Abdulaziz-nasser/IRD-MAX/hardware/README.md

# Hardware

The Jetson processes camera images and sends driving commands to the Arduino Uno over USB. The Arduino controls the RC380 motor and MG996R steering servo and reads the sensors.

Use the [Uno pin map](PINOUT.md) to check signal connections and the [power notes](power/) for supply information.

| Component | Quantity | Photo or reference |
|---|---|---|
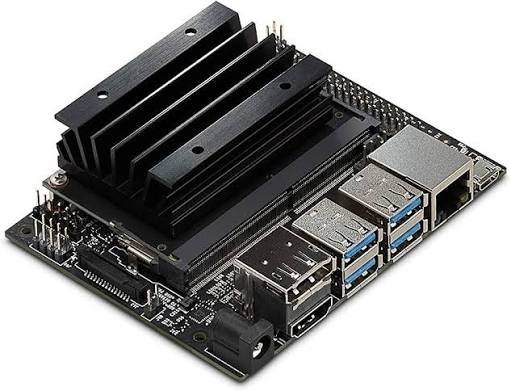
[picture p3: hardware/jetson-nano.png]
NVIDIA Jetson Nano — product reference photo
| NVIDIA Jetson Nano | 1 |  |
| Arduino Uno R3 with shield | 1 | <a href="https://store.arduino.cc/products/arduino-uno-rev3">Arduino Uno with shield — product reference photo</a> <a href="https://thinkrobotics.com/products/io-sensor-shield-online">Arduino Uno with shield — product reference photo</a> |
| HW-039 module | 1 | <a href="https://kitsguru.com/products/double-bts7960b-dc-43a-stepper-motor-driver-h-bridge-pwm-for-arduino-smart-car">HW-039 module — product reference photo</a> |
| IMX477 camera | 1 | <a href="https://thinkrobotics.com/products/waveshare-imx477-160-12-3mp-camera-160-fov">IMX477 camera — product reference photo</a> |
| DFRobot ultrasonic sensors | 4 | <a href="https://www.dfrobot.com/product-2172.html">DFRobot ultrasonic sensors — product reference photo</a> |
| DFRobot BNO055 9-axis IMU | 1 | <a href="https://www.dfrobot.com/product-2142.html">DFRobot 9-axis IMU — product reference photo</a> |
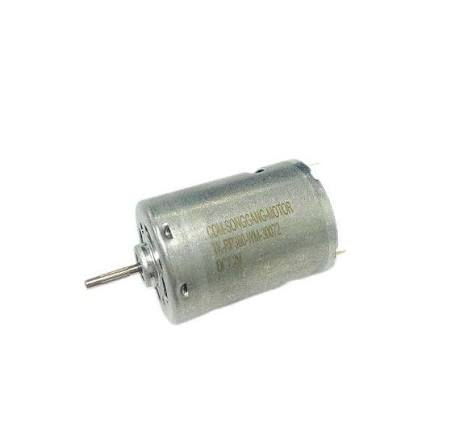
[picture p4: hardware/rc380-drive-motor.png]
Brushed drive motor — product reference photo
| RC380 brushed drive motor, marked 7.2 V | 1 | <br>[Installed vehicle views](../README.md#vehicle-photos) |
| MG996R steering servo | 1 | <a href="https://towerpro.com.tw/product/mg996r/">MG996R steering servo — product reference photo</a> |
| Rotary encoder | 1 | <a href="https://kitsguru.com/products/m274-360-degree-rotary-encoder-brick-sensor-module">Rotary encoder — product reference photo</a> |
| Buzzer | 1 | <a href="https://www.dfrobot.com/product-84.html">Buzzer — product reference photo</a> |
| Battery cell holder | 1 | <a href="https://quartzcomponents.com/products/4-cell-18650-battery-holder">Battery cell holder — product reference photo</a> |
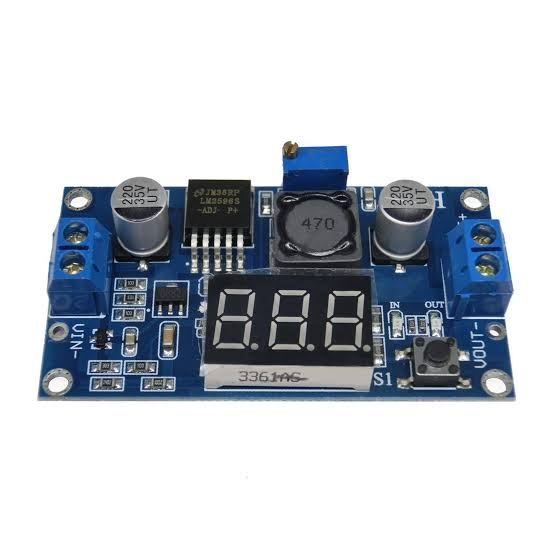
[picture p5: hardware/dc-dc-step-down-regulator.png]
DC-DC step-down regulator — product reference photo
| DC-DC step-down regulator | See power notes |  |
| Start button | 1 | <a href="https://www.dfrobot.com/product-1097.html">Start button — product reference photo</a> |

Most of these are product-reference photos rather than photos of our installed parts. We check the label on the real component before using any linked voltage or current rating.

Wiring: [circuit diagram](../schematic/circuit-diagram.png) and [machine schematic](../schematic/machine-schematic.png).

We use four ultrasonic sensors. The Open controller reads front, left and right; the Obstacle controller also reads the rear distance on D10. Encoder inputs A2/A3 are used by the Obstacle and older development controllers, but not by the Open controller. See the [version-specific pin map](PINOUT.md).

The computer installed in our car is the original Jetson Nano, not the Orin Nano. The [vehicle photos](../README.md#vehicle-photos) show the actual build.
