Abdulaziz-nasser/IRD-MAX/testing/README.md

# Testing

These clips show three parts of our testing: track driving, a printed body part and the steering system. Each entry states what we checked and what can be seen in the video.

For setup, measurements and repeat-test notes, use the [test procedure](PROCEDURE.md) and [calibration tools](../software/tools/).

## Test 1 — Track Driving and Turning

**Purpose:** Check the car's movement and its response at the start of a corner.

**Test:** The car was placed on the field and driven toward the corner.

**Result:** The car drove across the track and started turning. The recording ended before it completed the corner, so this video is not evidence of a full run.

**Evidence:**

https://github.com/user-attachments/assets/b2263392-7ead-4043-8df9-3296c7f84011

## Test 2 — 3D-Printed Body Part

**Purpose:** Check the shape of one blue body part before installing it on the car.

**Test:** The part was observed during the 3D-printing process.

**Result:** The part finished printing, and we checked its shape before fitting it to the car.

**Evidence:**

https://github.com/user-attachments/assets/e96c9f82-ebd5-4437-964f-ed16c3f7a8d7

## Test 3 — Steering System

**Purpose:** Check the steering servo, linkage, and wheel movement before driving on the track.

**Test:** The steering system was operated while the car was on the table.

**Result:** The servo moved the linkage and turned the front wheels.

**Evidence:**

https://github.com/user-attachments/assets/8760a0b2-5b68-4e45-907e-386e316cc666

For problems found and fixed during development, see [our journal](../Journal.md).
