Abdulaziz-nasser/IRD-MAX/(commit log)

2026-09-15 Simplify software README with Jetson and Arduino responsibilities
2026-09-15 Document yaw driving problem and add slow comparison programs
    [slow_with_yaw.py, slow_without_yaw.py]
2026-09-17 Add DC-DC step-down regulator to hardware
2026-09-17 Add CAD and power system documentation
2026-09-17 Add calibration tools and document Nano/Uno setup
2026-09-22 Add final Open Challenge Jetson program
2026-09-22 Add final Open Challenge Arduino controller
2026-09-22 Add final Obstacle Challenge Arduino controller
2026-09-22 Rename Open Challenge Jetson program
2026-09-22 Rename Open Challenge Arduino controller
2026-09-22 Rename Obstacle Challenge Jetson program
2026-09-22 Rename Obstacle Challenge Arduino controller
2026-09-22 Refresh hardware photos and simplify schematic documentation
2026-09-22 Use our team voice in schematic descriptions
2026-09-22 Chassis and CAD views
2026-09-22 Components and power
2026-09-22 Wiring diagrams
2026-09-22 Add Jetson Nano, regulator and drive motor photos
2026-09-22 Correct CAD view mapping
2026-09-22 Document distance and encoder troubleshooting
